WillyAG/PoolWind/hardware/README.md

# Hardware

License: see [LICENSE.md](../LICENSE.md).

How to build it: see the [build guide](../docs/BUILD_GUIDE.md).

## Contents

- [Parts list](PARTS_LIST.md), with approximate 2026 prices.
- `schematics/` — the interface board design as a [Fritzing](https://fritzing.org)
  project (`PoolWind_interface_board.fzz`). Open it in Fritzing to see the
  breadboard, schematic and PCB views, or to change the design.
  `PoolWind_interface_board_bb.png`, `PoolWind_interface_board_pcb.png` and
  `PoolWind_interface_board_pcb_bottom.png` are pictures of the wiring
  (breadboard view) and the board layout from above and below (PCB view).
- `gerbers/` — the interface board's manufacturing files.
  **`PoolWind_PCB_gerbers.zip`** is ready to upload to any PCB maker (for example
  [JLCPCB](https://jlcpcb.com), [PCBWay](https://www.pcbway.com),
  [OSH Park](https://oshpark.com) or [Aisler](https://aisler.net)):
  two-layer board, 117 × 88 mm (4.59 × 3.46 in). The same files are also
  there unzipped, with a pick-and-place list (`_pnp.xy`).
- `PoolWind_PCB_preview.png` — a picture of the board drawn from the Gerber
  files (top copper yellow, bottom copper orange, silkscreen white).

Each relay has its own two wires to the remote (the "8-wire" design,
2026-10-15). Remote jack pins: 1 = 5 V, 3 and 6 = Up, 4 and 2 = Down,
5 and 7 = On/Off, 8 = ground. Checked 2026-10-15: the Gerber files' copper
connects exactly these pins, and the schematic, breadboard and PCB views
agree.

## Connections used by the software

| Function | Connection |
|---|---|
| Jet speed Up (remote button) | Relay on GPIO 17 (active low) |
| Jet speed Down (remote button) | Relay on GPIO 18 (active low) |
| Pump On/Off (remote button) | Relay on GPIO 27 (active low, 2-second pulse) |
| Jet speed feedback | INA260 sensor on I2C at address 0x40, reading the Pace Display port voltage on its VBUS pin (its V+ to VBUS jumper cut) |
| Pump running | GPIO 23, from the Pace Display port's pump line (about 38 V while the pump runs) through the R6/R3 divider: high while the pump runs |
| Camera | Spedal 920 Pro Conference Camera (120°, USB) above the swim area, opened as video device 0 |

The program never energizes Up and Down at the same time. Before pressing
On/Off, it releases Up and Down, and after pressing it, it checks GPIO 23 to
see whether the pump followed.

The Raspberry Pi pin numbers and the RJ45 jack pins are in the
[build guide, section 4](../docs/BUILD_GUIDE.md#4-the-interface-board).
I2C must be turned on (the install script does this; see the
[setup guide, section 3](../docs/SETUP_GUIDE.md#3-installing-poolwind)).
