WillyAG/PoolWind/hardware/gerbers_8wire/PoolWind_interface_board_8wire_drill.txt

; NON-PLATED HOLES START AT T1
; THROUGH (PLATED) HOLES START AT T100
M48
INCH
T1C0.125984
T100C0.098425
T101C0.039370
T102C0.043307
T103C0.015748
T104C0.035000
%
T1
X008555Y029672
X006555Y029672
X002055Y029672
X013055Y029672
T100
X010406Y018622
X003406Y018622
T101
X009406Y011622
X012555Y027172
X006055Y027172
X004555Y026172
X008406Y011622
X010555Y027172
X005055Y027172
X006406Y011622
X003055Y027172
X005406Y011622
X009055Y026172
X012055Y026172
X011555Y027172
X003555Y026172
X007406Y011622
X010406Y011622
X004055Y027172
X002555Y026172
X004406Y011622
X003406Y011622
X011055Y026172
X010055Y026172
X009555Y027172
X005555Y026172
T102
X007906Y018122
X005906Y018122
T103
X021888Y030393
X007559Y015338
X010920Y012458
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
