WillyAG/PoolWind/hardware/PoolWind_PCB_preview.png

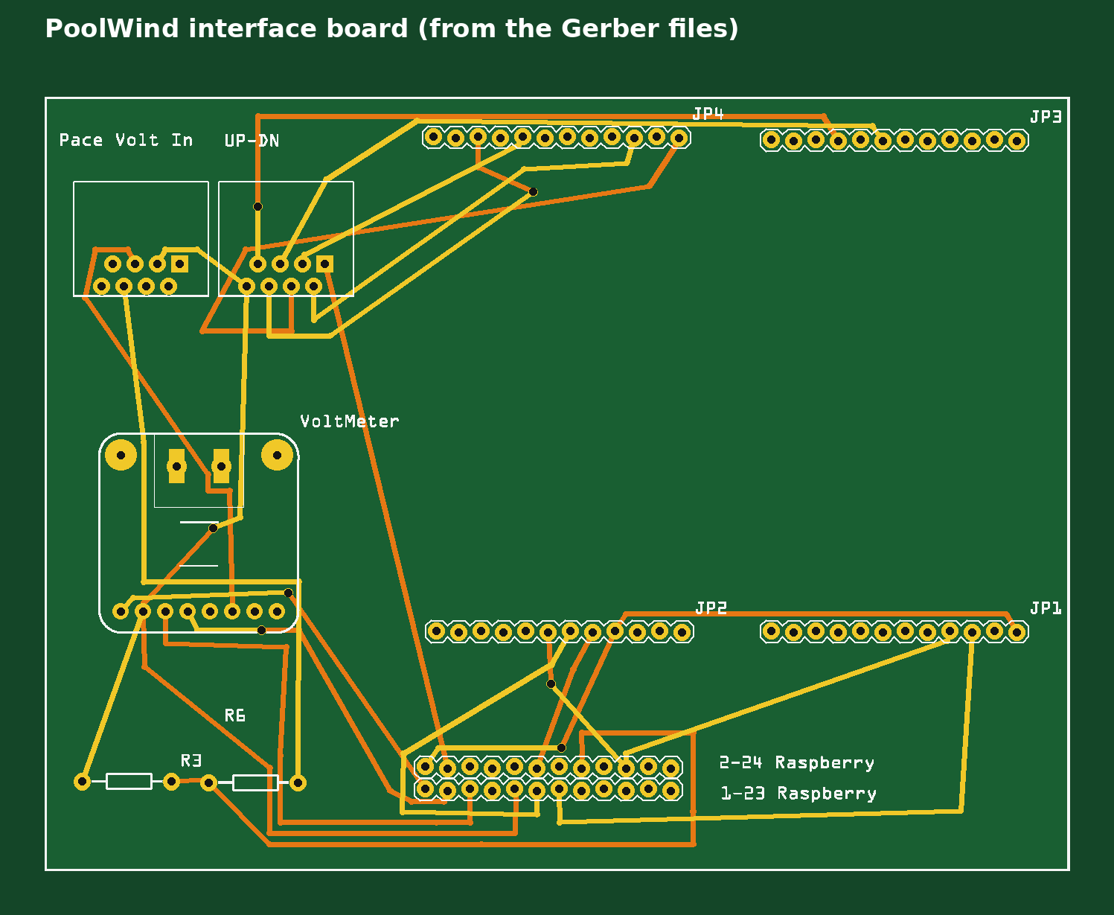
hardware/PoolWind_PCB_preview.png
