WillyAG/PoolWind/(list of files, drawings)

Other design files:
hardware/schematics/PoolWind_interface_board.fzz
