WillyAG/PoolWind/(commit log)

2026-10-14 PoolWind release: program, install script, documents and hardware files
    [PoolWind_interface_board.fzz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]
2026-10-14 Build guide: new section 3, The Raspberry Pi (kit, SD card, GPIO pins, ports); later sections renumbered
2026-10-14 Build guide: the author's kit case keeps its lid on; the ribbon cable fits through an opening
2026-10-14 Build guide: the Pi's own case is an ordinary case; the station's box does the waterproofing
2026-10-14 Revise Raspberry Pi case and microSD card instructions
    Updated case description for Raspberry Pi and clarified microSD card recommendations.
2026-10-14 Build guide: the Gerber ZIP includes the drill file
2026-10-14 Build guide: tip for makers that expect a .drl drill file
2026-10-14 Update ribbon cable connection instructions in BUILD_GUIDE
    Clarified ribbon cable connection instructions for Raspberry Pi and interface board.
2026-10-14 Ribbon cable hint (Bill); fewer brand mentions; Pace port voltage described as observed; warranty note
    - Build guide: Bill's ribbon cable hint, tidied (40 pins, table intro back)
    - Endless Pools named only for compatibility, the remote and the parts row;
    Martec BT-433M named with the EP1
    - Pace Display port: say what is known (voltage tracks jet speed), not how
    the Pace Display uses it; shipped pace table 'should be close' for the
    same model, unchecked elsewhere
    - SAFETY: warranty sentence; opening the control box only with power off
2026-10-14 Build guide 4: orientation warning before the ribbon cable hint
2026-10-14 Build guide 4: relay COM/NO contacts, no soldering order, how the relay modules are wired and held
2026-10-14 Interface board design: schematic wires for UP-DN pin 5 rerouted so they no longer touch pin 6's (drawing only; connections and PCB unchanged)
    [PoolWind_interface_board.fzz]
2026-10-14 Build guide 4 and parts list: header sizes (2x12, 4x 1x12, 1x8 socket); current boards' jack labels
2026-10-14 Build guide 4: photos of the cut VB jumper and the relay wiring (JP1-JP4)
2026-10-14 Photos of the poolside station (running, inside, spread out, heatsink), not yet placed in the guide
2026-10-14 Build guide 5: wire colors and contact positions, opening, foam tape, watertight box, pairing; pin 6 paragraph reworded; two-wire-per-button alternative
2026-10-14 Build guide 5: inside photo labeled with RJ45 pin numbers; pin 6 on the Up button's left side, pin 1 on the right edge
2026-10-15 8-wire interface board: each relay has its own two remote wires (Fritzing design, Gerbers, preview); hardware README
    [PoolWind_interface_board_8wire.fzz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]
2026-10-15 Interface board: the 8-wire design is now the only version (design, Gerbers, preview, Fritzing pictures incl. bottom view); hardware README
    [PoolWind_interface_board.fzz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]
2026-10-15 Build guide: 8-wire board throughout (remote check, relay contacts, jack and remote pin tables, generic remotes); first-batch rear photo and added-wire text replaced by Fritzing bottom view; drill fi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
2026-10-15 Build guide: 8-wire remote photo labeled; colors for pins 2 and 7; board photo is an earlier version
2026-10-15 Build guide section 6: Bill's edits (spelling), phone plug type, Pace jack pinout, cable check, splitter subsection
2026-10-16 SAFETY.md: certified power supplies, outlet placement and GFCI (NEC 680), Pace cable ground is not a safety ground
2026-10-16 Interface board: R6 100k / R3 7.5k divider for the 38 V Pace power line (was 220/220, which would destroy GPIO 23); parts list row 14
    Board copper, mask, silk and drill files are unchanged; only the part values
    (design file and pick-and-place listing) change. The parts stay unfitted.
    [PoolWind_interface_board.fzz]
2026-10-16 Build guide section 6: Bill's edits (24 V power, pinout notes, ground note)
2026-10-16 Build guide: R3/R6 new values and purpose, 38 V Pace power, 6P6C plug, section 6 tidy, safer cable check (INA260 unplugged)
2026-10-16 Build guide: Bill's edits to sections 6 and 8 (port location, his cable check, straight-through 4-wire cable, splitter, heat), merged with Claude's 07e7b55 fixes that an editor save had reverted; sec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
2026-10-17 User manual: zone highlight; leaving the pool screen; On/Off on the calendar and plot
    - Section 3: tap the picture for the zone highlight
    - Section 4: new 'Seeing your zone: the zone highlight' after the sprint
    warning (the band shows the water lag)
    - Section 7: leaving the pool screen winds down and lets go of UP/DN,
    On/Off stays (calendar and plot buttons), back winds down and starts
    slow; calendar refuses days without swims ('pick a green date');
    click on the video toggles the highlight; zone highlight in 'What to
    look for'
    - Section 8: zoneHighlight, zoneHighlightLevel (main settings file only)
    Describes v15.2: to be published together with the program recopy.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
2026-10-17 User manual: logRate section; Bill's edits; links to the renamed zone highlight heading
    - Section 8: new 'logRate: how often PoolWind records' (snapshots = log
    line + video frame; 5 vs 15 table; why and how to change it; next
    start; mixed rates play correctly). Section 6 and the settings table
    link to it.
    - Bill's edits: heading 'Seeing the jet's zone', the band as a jet speed
    meter, the leaving-the-pool wording.
    - Links to the renamed heading fixed (3 in the manual, 1 in the setup
    guide).
2026-10-17 User manual: pump buttons are light red; off the pool screen they ask 'Are you sure?' (and Bill's edits)
2026-10-17 Program: v15.2
    Since v15.1: swim zone highlight (tap the picture; the jet's zone, with
    the water lag, none in Hold); USB stick ejected when PoolWind closes
    ('ejectStickOnClose', also on a stick); pump buttons light red, asking
    "Are you sure?" off the pool screen; Compress Gaps treats a cluster of
    pauses as one; plot date MM-DD-YYYY; the control algorithm a developer
    setting (main defaults file only); developer switches comBar and
    readouts; zone columns in the swim log.
2026-10-18 README: no GitHub account needed (open in the browser if the app asks to sign in); build guide: Pace port voltage about 1.2 V to 3.2 V, as in setup guide 5.2
2026-10-18 README: PoolWind™ in the title (unregistered trademark, in use since 2021)
2026-10-18 Build guide 9: On/Off relay click before connecting; Up/Down checked with Hold once the remote and Pace cable are connected
2026-10-18 usablePoolLength (was poolLength) in the setup guide and the sample calibration file
2026-10-20 Shipped pace table now measured with the calibration program's PingPong mode (ping-pong balls timed by the camera)
    The setup guide says how the table was measured and that the
    surface-speed-to-pace factor was set by the author; Pace Display figures
    removed (the 1:00 reading above 2.6 V, the old table's example rows);
    5.3's safety range is now about 4:17 to 1:46. The program no longer links
    the Pace Display manual, and its comment examples don't quote the old
    table. Existing installs keep their own calibration file.
2026-10-21 Guides for v15.5 (local branch, not published until v15.5 is): the calibration built into PoolWind (voltage scan, Pace Entry, PingPong), Pace correction while swimming, Swimmer limits and zone limits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
    The shipped defaults keep the 3:00 top pace (Bill, 2026-10-21: "a, keep
    the 3:00 pace in shipped defaults").
2026-10-21 Guides: the camera check's Adjust in more detail, and its Check the camera message (moved too far, pool not recognized)
2026-10-22 Setup guide section 4: Bill's edits (unsaved in VSCode since before section 12), merged with the current guide
2026-10-22 install_windows.bat: PoolWind on a PC as a demo (Python via winget if needed, the tested packages, the program and settings from GitHub, the sample video from the latest Release, a desktop icon); .gi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
2026-10-22 install.sh downloads the sample video (latest Release; a failure doesn't stop the install). Setup guide review: turn the demo off in First start; installer list (sample video, Claude icon); section 8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
2026-10-22 Build guide review: try the PC demo before buying; first power-up checks turn the demo off first, On/Off gives two clicks 2 s apart; station section wording; units and README link
2026-10-22 CLAUDE.md: Demo (fail-safe default, applied last, main file only), On/Off now, install.sh's sample video and Claude icon, install_windows.bat, the video setting, Windows support, the panels, camera c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
2026-10-23 Shipped calibration: the author's present pace table (the voltage scan's 37 rows, 1.229-2.671 V, with the PingPong paces), jetVoltageRange, jetSteps and '# zones or auto' as v15.5 writes them; no Ini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
2026-10-23 software/poolwind.py is v15.5: demo mode with the sample video, Windows support, the wind-down at On/Off with On/Off now, live Set Swim Area, the calibration built in, the pool controlled by jet step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
2026-10-25 Build guide: link to Discussions at the remote's wiring (Bill, 2026-10-25)
2026-10-29 Guides for v15.6-v15.7: user manual (welcome screen; a stick plugged in or pulled while PoolWind runs; the stick's own Pace table; Pace correction rewritten: whose table, typing while swimming, red, 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
2026-10-30 Build guide section 7: "Not enough height?" -- the angle needed at 5½, 4 and 3 ft, the 120° camera at one end looking along the pool, wider USB cameras (fisheye bending, not yet corrected), a low cam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
2026-10-30 User manual, Pace correction: both ends are the pool's calibrated Paces (no longer always 7:00 at the bottom)
2026-11-01 Guides for v15.7: Bill's rewrites and the session's changes
    User manual: Bill's rewrite of Swim Plot (selecting dates, the plot and
    video, Master vs Swimmer datasets); goto MPH / goto Pace, PACE / MPH on the
    date's line, the coordinate box, Avg Pace and Distance overall, Compress
    Gaps keeps the cursor and values; re-calibration section with the
    arithmetic; "Your earlier swims change too"; Make permanent greyed; typo
    and formatting fixes; links to the removed "Paces in today's table" now to
    Master vs Swimmer datasets.
    Setup guide: Bill's 5.1 datasets section and 5.3-5.7 rewrites; scan
    starts over, "Write scan to Master calibration file?", the "-----" steps
    in Pace Entry and PingPong, Entry c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
2026-11-01 CLAUDE.md: a continuous-voltage pool's plan starts at 30 steps (Bill, 2026-11-01: "I'd suggest 30 steps after what you said about it.")
2026-11-01 v15.7 for testing: the program and the downloaded files
    software/poolwind.py: PoolWind v15.7 (poolwindAI_v15.7.py, PoolWind
    31abd6a). poolwind_calibration.txt: written by v15.7's own save, the
    author's Master Pace table (26 rows, 7:00 to 1:25), swim area, swim
    length, center lane, bodyDrag / deltaBodyDrag; no scan results (the
    builder's scan writes them). poolwind_defaults.txt: 'zoneMin, Max':
    (6, 12) in place of the Pace range, no ejectStickOnClose. WHATS_NEW for
    v15.7; software README. install.sh downloads the sample video from the
    repository it was cloned from (gh for a private one). Setup guide and
    user manual: the shipped zones.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
2026-11-02 README: Hardware summary says every file can be read or downloaded on GitHub before buying the Pi (Bill, 2026-11-02: "The user may not even have bought the Pi yet. How can we make the files available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
2026-11-02 Build guide, parts list, hardware README: example PCB makers next to "any PCB maker": JLCPCB, PCBWay, OSH Park, Aisler, each linked (Bill, 2026-11-02: "Just add the example makers next to \"any PCB m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
2026-11-02 Build guide: link to the manual's section 7 fixed (Reviewing your swims), 6 ft / 15 ft, Raspberry Pi board, pass-through, paragraph break in section 8; note under the board photo shortened to its las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
2026-11-02 User manual: links to setup guide 5.3 and 5.5 fixed (their headings end in "- Master dataset"), typos and format, "goto MPH" in the Swim Plot picture's description; menu row: Calibrate pool... "for t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
2026-11-02 README: double spaces, "you're", "the UP and DN screen buttons", "if the swimmer leaves"; Features: "Jet speed limits: the jet never goes faster than the top the builder chose during calibration" (wa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
2026-11-02 Hardware README: links to build guide section 4 and setup guide section 3; parts list: the INA260 plugs into a socket strip, desiccant packs for the station case too (row 22), total about $450–550 (a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
2026-11-02 CLAUDE.md checked against v15.7: '# zones or auto' gone, DRIFT_SCALE 1.67, Copy Master values, recordRawVideo in the defaults file, swim zone width, zone limits, the demo video from the cloned reposi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
2026-11-02 New screenshots for v15.7: the pool screen (menu button at 8, 8, version at the top, zone highlight) and Swim Plot (goto MPH, PACE, Avg Pace overall, the Time / Pace box); their descriptions in the u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
2026-11-02 Setup guide, section 6: a defaults or calibration file PoolWind can't start with, a misspelled setting name or a wrong word shows a box with the file, line and problem (Bill, 2026-11-02: "That works 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
2026-11-02 Setup guide: copy and paste the install lines (section 3: the guide in the Pi's browser, GitHub's copy button, right-click Paste or Ctrl+Shift+V; section 10 points to it) (Bill, 2026-11-02: "The line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
2026-11-02 The Pi is no longer a demo after install: the shipped defaults file has no 'Demo' line, and v15.7's built-in is True only on a PC (software/poolwind.py = ~/poolwind 6b63544, with the start-up error b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
2026-11-02 Wind-down at start and close: software/poolwind.py = ~/poolwind 83bc29b; SAFETY.md (Bill's lines, "its", Set Swim Area / Calibrate pool / Swim Plot added), user manual sections 1 and 5 (closing winds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
2026-11-02 Swimmer limits' Manual Settings (software/poolwind.py = ~/poolwind cf1694f): user manual (Swimmer limits, a new stick, Your settings, logRate), WHATS_NEW; SAFETY.md: Bill's wind-down list as sub-bull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
2026-11-02 User manual without the settings files: section 8 lists the settings as Swimmer limits shows them and says in one line where they're stored; logRate is "frames per second" throughout; file names and 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
2026-11-02 Setup guide brought up to today's program: section 4 (the wind-down box at start, the no-sensor box), 5.8 (the jet winds down at start, close, OnOff, Set Swim Area and the calibration), section 6 (Sw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
2026-11-02 CLAUDE.md: the relay rule for a Pi that isn't a demo by default (any run without a 'Demo': True line drives the relays), the start-up boxes and Swimmer limits' settings under Finding out what's wrong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
2026-11-02 README: the USB stick feature lists the settings Swimmer limits sets, "5 frames per second"; Support: Claude Code in the PoolWind-download folder (Bill, 2026-11-02: "Yes, commit and push it to PoolWi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
2026-11-02 Full check of the guides: user manual, Pace correction's Details is a link; CLAUDE.md, install.sh downloads the sample video (desk tests, a 'Demo': True run) (Bill, 2026-11-02: "Yes, check them all a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
2026-11-02 Build guide, read in full: "3 ft"; ordering the board: a maker without a preview (JLCPCB), check the size it read; R3/R6 would detect whether the pump is running (Bill, 2026-11-02: "Yes, commit and p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
2026-11-02 Parts list, row 14: R3/R6 would detect whether the pump is running, as in the build guide (Bill, 2026-11-02: "Yes, commit and push it to PoolWindTest")
2026-11-03 v15.8 pump sensing: software/poolwind.py and the guides
    PoolWind now sees whether the pump runs (R6/R3 to GPIO 23). software/
    poolwind.py is v15.8. Build guide: R3/R6 fitted (100 k / 7.5 k, or any
    pair giving 2.4-2.8 V; don't swap them), the pin and jack tables, pin 6
    checked with the Pace cable, the power-up checks. Parts list row 14, the
    hardware README's connections. Setup guide: the start box, OnOff shows the
    pump, Start offers to turn it on, desk settings, updating to v15.8 needs
    R6/R3. User manual: OnOff (red and down while the pump runs, retries,
    the other-remote box, Stop pump now, 5 minutes without a swimmer), pausing
    with the pump off, closing with it running, Swim Plot's Pump butt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
2026-11-04 Pace correction: the button says what the pool swims now ("Now swimming with 'pending' / 'stored' values", greyed with nothing pending), and bold marks the column the pool really uses (neither while 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
2026-11-04 Pace correction for a swimmer standing wet at the pool: three short steps for instructions, a short Details, the red warning simpler, "Fast" and "Slow" gone, "Copy Pool Default to \"Your pending\"" (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
2026-11-04 Pace correction: no graph in a narrow window rather than a sliver with its minutes crammed under it; a tapped zone moves the yellow bar with the jet, and only while the swim runs (Begin / Resume show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
2026-11-04 Pace correction in a narrow window: the columns close up so the graph keeps its room (about 110 px in a 410 px box) instead of going (Bill, 2026-11-04: "Now the graph is completely gone. We need it b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
2026-11-04 Pace correction: the swimmer's limit labels on the graph's roomier side of the curve; in a narrow window the columns closer still (graph about 135 px in a 410 px box), the Now swimming button wide en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
2026-11-06 v15.9 Swimmer limits: Bill's instructions (Manual / Auto) and Details; Start starts the swim (it counts, the pump asked for if off); "Start swimming" until the swimmer is seen, again after Low limit 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
2026-11-06 v15.9 Swimmer limits: the box as tall as its contents (no gaps around the title and text) and kept on the screen, Cancel and Save included; Details a small button on the Auto line (Bill, 2026-11-06: 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
2026-11-06 v15.9 Swimmer limits: the box stays where it was dragged while its buttons are pressed (only raised if it grows past the bottom) (Bill, 2026-11-06: "if I move the box to view the swimmer but still ca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
2026-11-07 v15.9 guides checked: SAFETY and user manual (Set Swim Area leaves the swim running, no pump auto-off while open; Details in Swimmer limits); program: Swimmer limits size fallback fixed
